katharinanilss/SO_26_EPS_PCB/so_26_eps_pcb/so_26_eps_pcb.kicad_pcb

## KiCad design so_26_eps_pcb/so_26_eps_pcb.kicad_pcb (2026-03-01)

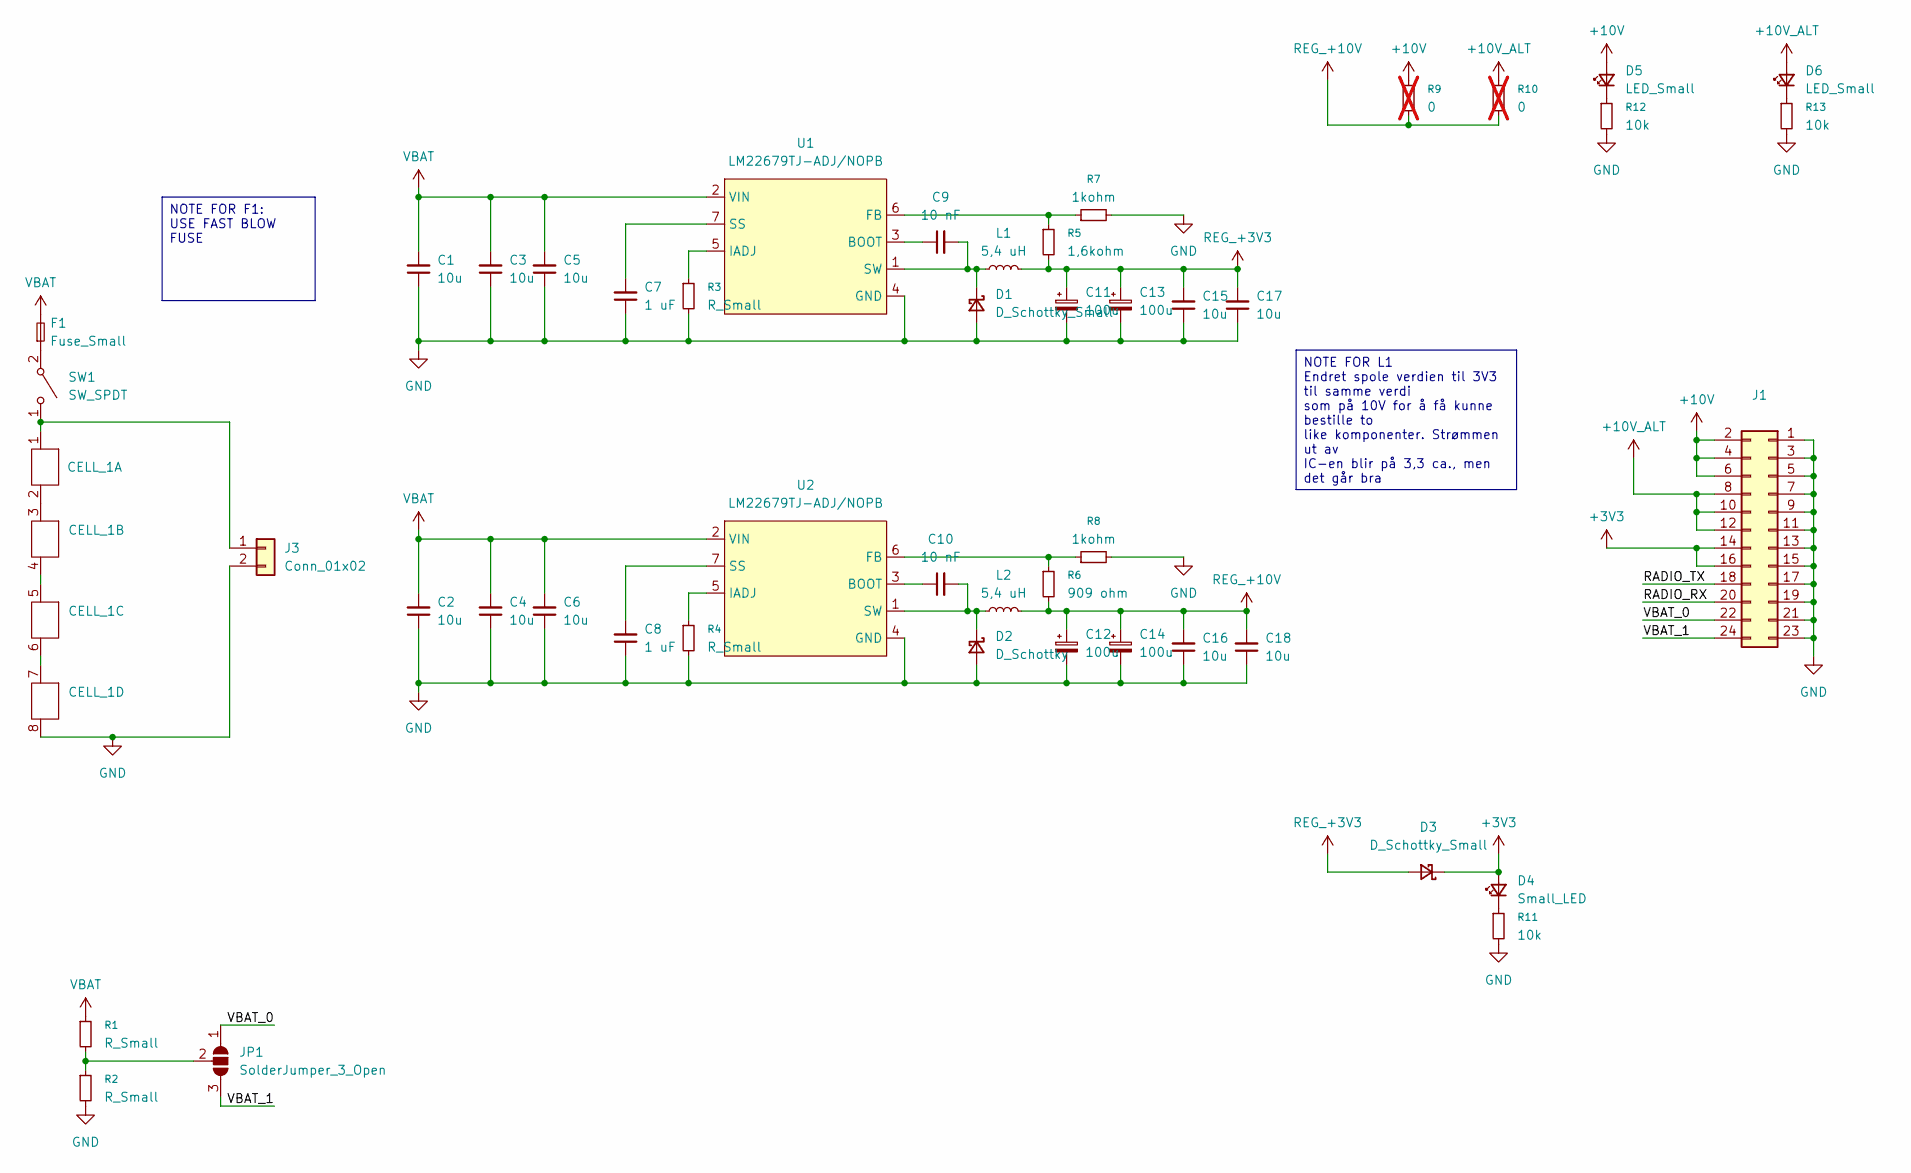
[picture p1: schematic so_26_eps_pcb.kicad_sch, SO26 - EPS]

Parts:
C1, C2, C3, C4, C5, C6, C15, C16, C17, C18: 10u; C_1206_3216Metric_Pad1.33x1.80mm_HandSolder
C7, C8: 1 uF; C_1206_3216Metric_Pad1.33x1.80mm_HandSolder
C9, C10: 10 nF; C_0805_2012Metric_Pad1.18x1.45mm_HandSolder
C11, C12, C13, C14: 100u; CP_Radial_D6.3mm_P2.50mm
CELL_1: Battery holder
D1, D3: D_Schottky_Small; D_SOD-128
D2: D_Schottky; D_SOD-128
D4: Small_LED; LED_0805_2012Metric_Pad1.15x1.40mm_HandSolder
D5, D6: LED_Small; LED_0805_2012Metric_Pad1.15x1.40mm_HandSolder
F1: Fuse_Small; Surface Mount Fuse Block
J1: Conn_02x12_Odd_Even; PinSocket_2x12_P2.54mm_Vertical
J3: Conn_01x02; 01x02_header
JP1: SolderJumper_3_Open; SolderJumper-3_P2.0mm_Open_TrianglePad1.0x1.5mm_NumberLabels
L1, L2: 5,4 uH; SRU1048 Inductor
R1, R2, R3, R4: R_Small; R_0805_2012Metric_Pad1.20x1.40mm_HandSolder
R5: 1,6kohm; R_0805_2012Metric_Pad1.20x1.40mm_HandSolder
R6: 909 ohm; R_0805_2012Metric_Pad1.20x1.40mm_HandSolder
R7, R8: 1kohm; R_0805_2012Metric_Pad1.20x1.40mm_HandSolder
R9, R10: 0; R_2512_6332Metric_Pad1.40x3.35mm_HandSolder; not fitted
R11, R12, R13: 10k; R_0805_2012Metric_Pad1.20x1.40mm_HandSolder
SW1: SW_SPDT; finalswitchfinal
U1, U2: LM22679TJ-ADJ/NOPB; TO-263-7_TabPin4

Connections:
+3V3: D3.1 (K), D4.2 (A), J1.14, J1.16
+10V: D5.2 (A), J1.2, J1.4, J1.6, R9.1
+10V_ALT: D6.2 (A), J1.8, J1.10, J1.12, R10.1
/RADIO_RX: J1.20
/RADIO_TX: J1.18
/VBAT_0: J1.22, JP1.1 (A)
/VBAT_1: J1.24, JP1.3 (B)
GND: C1.1, C2.1, C3.1, C4.1, C5.1, C6.1, C7.1, C8.1, C11.2, C12.2, C13.2, C14.2, C15.1, C16.1, C17.1, C18.1, CELL_1.8, D1.2 (A), D2.2 (A), J1.1, J1.3, J1.5, J1.7, J1.9, J1.11, J1.13, J1.15, J1.17, J1.19, J1.21, J1.23, J3.2, R2.2, R3.2, R4.2, R7.2, R8.2, R11.2, R12.2, R13.2, U1.4 (GND), U2.4 (GND)
unnamed: CELL_1.2, CELL_1.3
unnamed: CELL_1.4, CELL_1.5
unnamed: CELL_1.6, CELL_1.7
unnamed: C9.2, D1.1 (K), L1.1, U1.1 (SW)
unnamed: C10.2, D2.1 (K), L2.1, U2.1 (SW)
unnamed: D4.1 (K), R11.1
unnamed: D5.1 (K), R12.1
unnamed: D6.1 (K), R13.1
unnamed: CELL_1.1, J3.1, SW1.1 (A)
unnamed: JP1.2 (C), R1.2, R2.1
unnamed 18: F1.1, SW1.2 (B); also elsewhere on the board
unnamed: C9.1, U1.3 (BOOT)
unnamed: R5.1, R7.1, U1.6 (FB)
unnamed: R3.1, U1.5 (IADJ)
unnamed: C7.2, U1.7 (SS)
unnamed: C10.1, U2.3 (BOOT)
unnamed: R6.1, R8.1, U2.6 (FB)
unnamed: R4.1, U2.5 (IADJ)
unnamed: C8.2, U2.7 (SS)
REG_+3V3: C11.1, C13.1, C15.2, C17.2, D3.2 (A), L1.2, R5.2
REG_+10V: C12.1, C14.1, C16.2, C18.2, L2.2, R6.2, R9.2, R10.2
VBAT: C1.2, C2.2, C3.2, C4.2, C5.2, C6.2, F1.2, R1.1, U1.2 (VIN), U2.2 (VIN); also elsewhere on the board

Notes on the sheet:
NOTE FOR F1: USE FAST BLOW FUSE
NOTE FOR L1 Endret spole verdien til 3V3 til samme verdi som på 10V for å få kunne bestille to like komponenter. Strømmen ut av IC-en blir på 3,3 ca., men det går bra

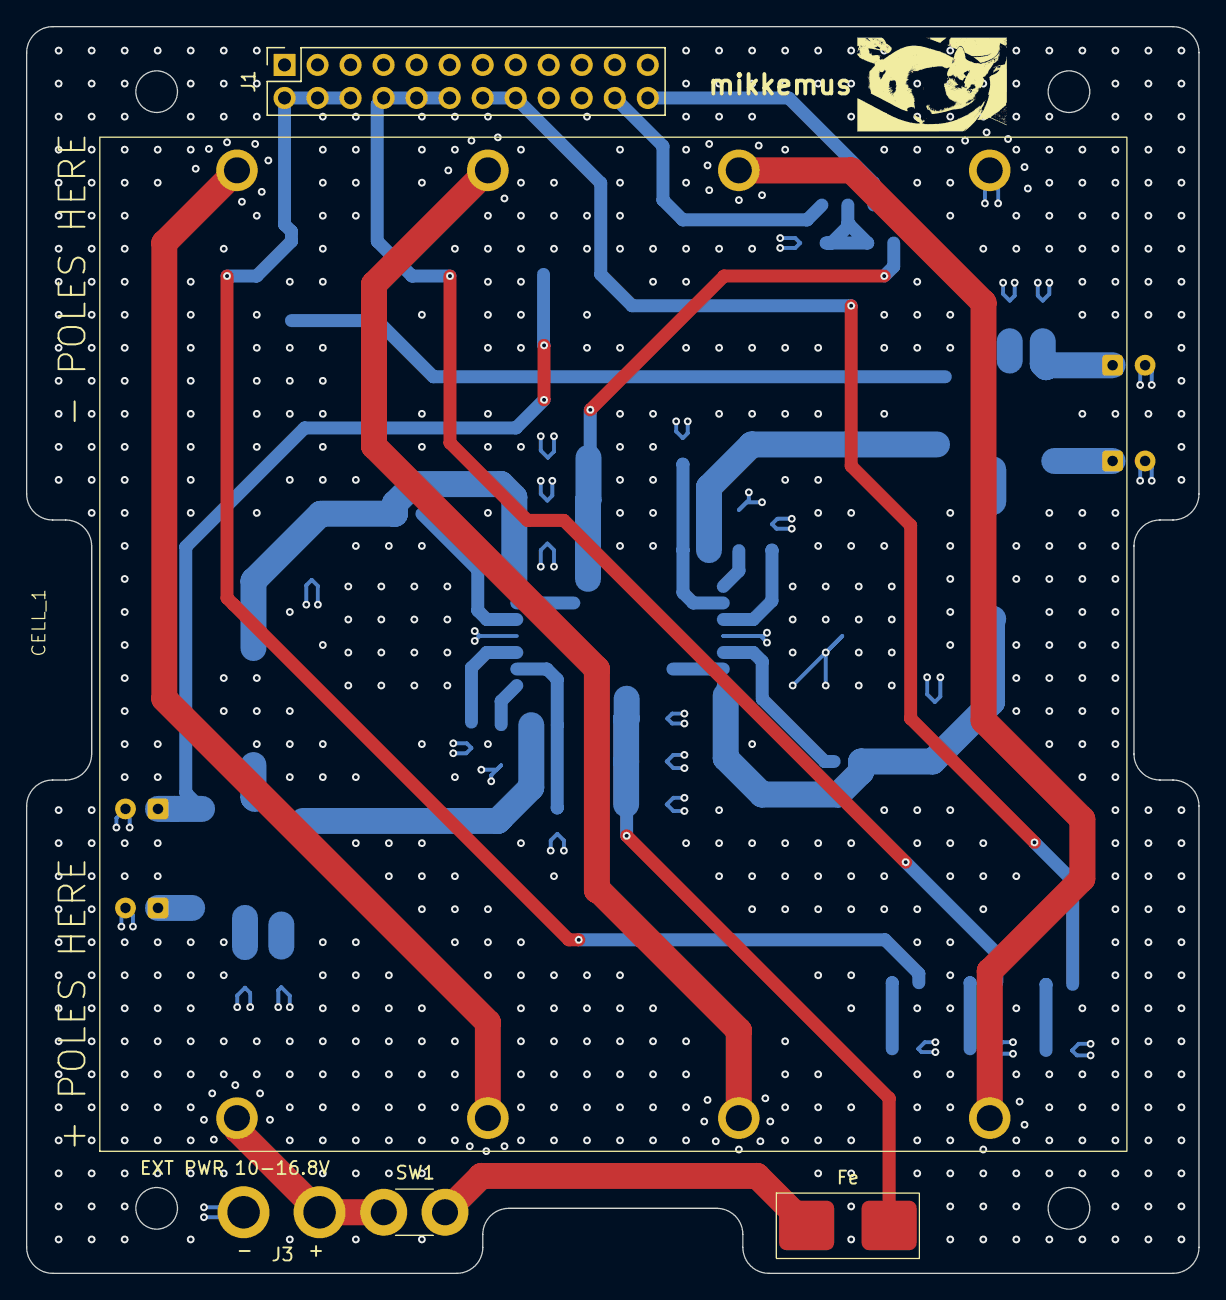
[picture p2: board so_26_eps_pcb.kicad_pcb from above]

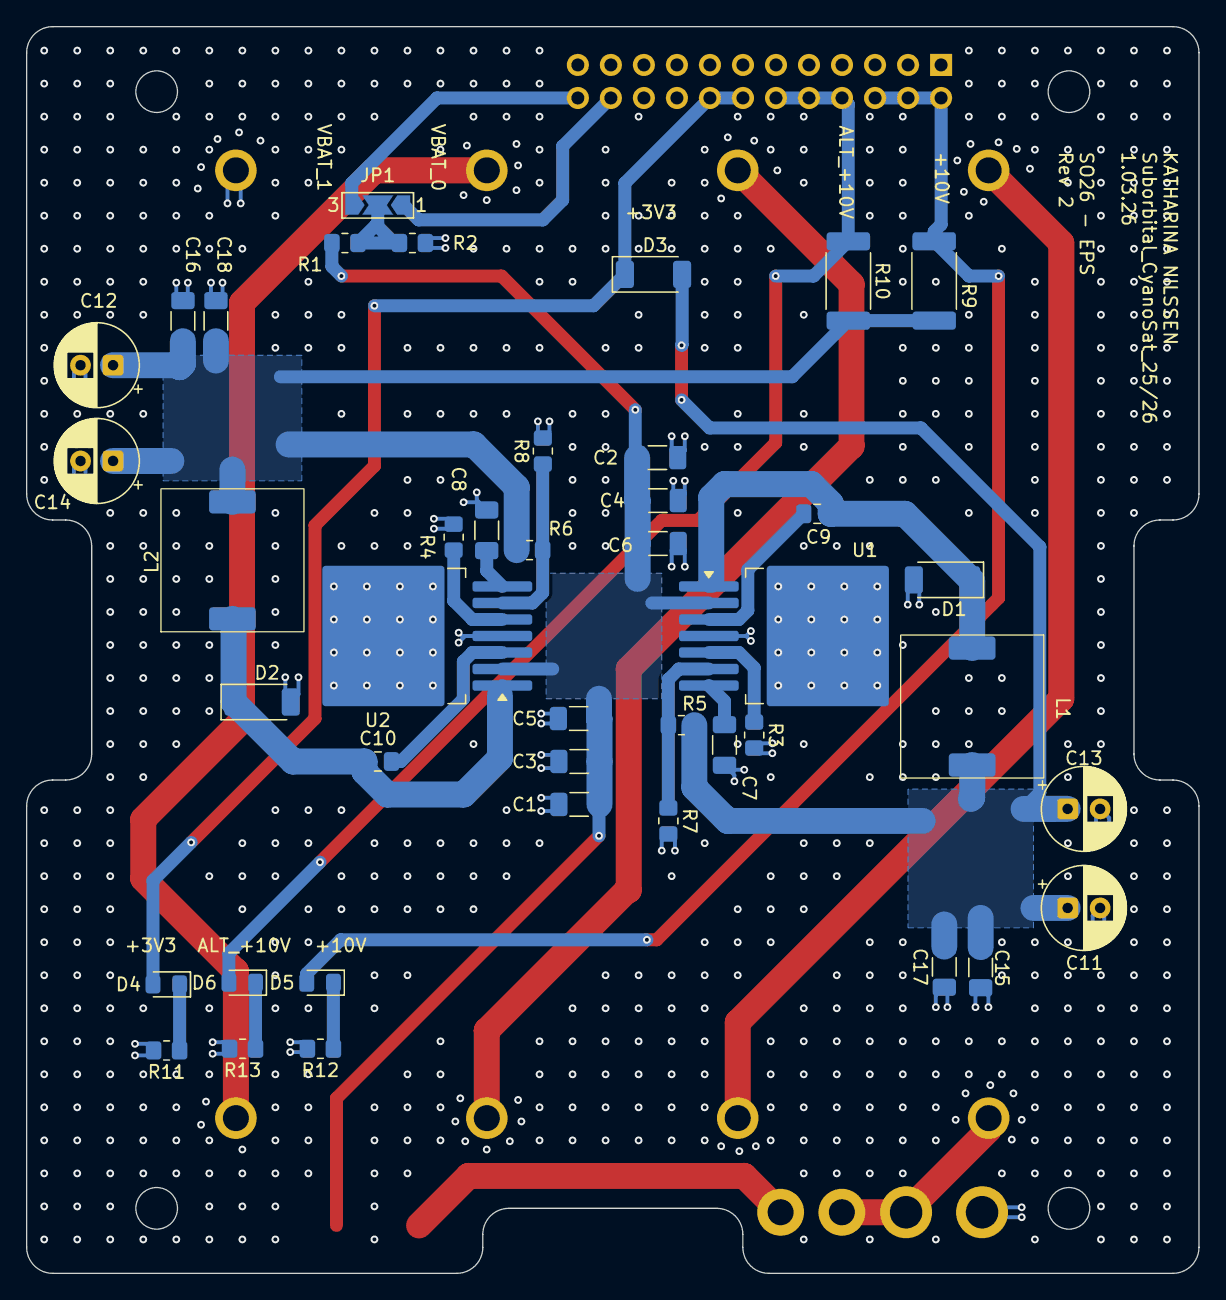
[picture p3: board so_26_eps_pcb.kicad_pcb from below]

Board: 4 copper layers, 90.2 x 95.9 mm, 48 parts (42 on the bottom side), 28 nets.

Other parts of the board:
Fe: Fuse_Small; Surface Mount Fuse Block
mikkemus: LOGO

Their connections:
unnamed 18: Fe.1; also elsewhere on the board
VBAT: Fe.2; also elsewhere on the board
