katharinanilss/SO_26_EPS_PCB/(commit log)

2026-01-28 init commit
    [so_26_eps_pcb.kicad_pcb, so_26_eps_pcb.kicad_sch]
2026-01-28 schematic: updated title block
    [so_26_eps_pcb.kicad_sch]
2026-02-06 Laget symbol for LM22679TJ-ADJ/NOPB
    Laget symbol for LM22679TJ-ADJ/NOPB
    [so_26_eps_pcb.kicad_sch]
2026-02-06 Laget ferdig regulatorer
    Mangler noen verdier
    [so_26_eps_pcb.kicad_sch]
2026-02-06 Battery
    Yuhhh
    [so_26_eps_pcb.kicad_sch]
2026-02-06 Battery symbol
    I have made one symbol, battery, that contains 4 different units which represent the 4 batteries in one battery holder
2026-02-06 Finished
    The circuit design are finished!!!
    [so_26_eps_pcb.kicad_sch]
2026-02-08 checked by aj
    schematic
    - fixed symbols and added capacitors
    pcb
    - added outline and stack + some footprints
    [so_26_eps_pcb.kicad_pcb, so_26_eps_pcb.kicad_sch]
2026-02-08 Made footprints
2026-02-08 Added test points
    [so_26_eps_pcb.kicad_sch]
2026-02-08 Changed properties for L
    [so_26_eps_pcb.kicad_pcb]
2026-02-08 Made a new battery holder
    Lets hope this one doesn’t get an error!
2026-02-08 Changed battery cells
    Gave input and outputs their own number
    [so_26_eps_pcb.kicad_sch]
2026-02-08 Made battery holder footprint
    [so_26_eps_pcb.kicad_sch]
2026-02-08 Added the last footprints
    [so_26_eps_pcb.kicad_pcb, so_26_eps_pcb.kicad_sch]
2026-02-08 Edits on PCB editor
2026-02-08 Last info about footprints
2026-02-09 Updated some footprints
    Deleted some old components and changed the size on the testpoints from 2mm in diameters to 1.5mm in diameters
    [so_26_eps_pcb.kicad_pcb]
2026-02-09 Made footprints for header by switch
2026-02-09 Added two headers to the system
    [so_26_eps_pcb.kicad_sch]
2026-02-09 pcb
    placed components close to each other to get an visual of the space
2026-02-09 Saved the pcb file
    [so_26_eps_pcb.kicad_pcb]
2026-02-10 Changed header footprint
    changed the header footprint, but it won’t update in the pcb editor
    [so_26_eps_pcb.kicad_pcb]
2026-02-10 Rev 1 of placing components on pcb
    [so_26_eps_pcb.kicad_pcb]
2026-02-10 Changed the place on some of the components on the PCB
    [so_26_eps_pcb.kicad_pcb]
2026-02-10 Saved the pcb
2026-02-10 Started some rooting
    [so_26_eps_pcb.kicad_pcb]
2026-02-10 Finished rooting the positive parts
    [so_26_eps_pcb.kicad_pcb]
2026-02-11 Saved
    some changes needs to be done on the wires
    [so_26_eps_pcb.kicad_pcb, so_26_eps_pcb.kicad_sch]
2026-02-11 Changed the thickness on some wires
    [so_26_eps_pcb.kicad_pcb]
2026-02-11 REV 1 FINAL
    SHEMATIC AND PCB CHECK
    DRC/ERC PASSED
    [so_26_eps_pcb.kicad_pcb, so_26_eps_pcb.kicad_sch]
2026-02-11 added via stiching
    [so_26_eps_pcb.kicad_pcb]
2026-02-11 added text "ext pwr 10-16.8v"
    [so_26_eps_pcb.kicad_pcb]
2026-02-11 added rev 1 text
    [bom.csv, designators.csv, positions.csv, so_26_eps_pcb.kicad_pcb]
2026-02-12 added text
    [so_26_eps_pcb.kicad_pcb, so_26_eps_pcb.kicad_sch]
2026-02-22 Placed components for 10V
    Also made a filled zone for VBAT
    [so_26_eps_pcb.kicad_pcb]
2026-02-22 Placed VBAT components and wiring
    [so_26_eps_pcb.kicad_pcb]
2026-02-24 Tried to make a design of the 10V reg and started on the 3V3 reg
2026-02-24 Started the 3V3 reg
    [so_26_eps_pcb.kicad_pcb]
2026-02-25 Finished the 3V3 reg
    [so_26_eps_pcb.kicad_pcb]
2026-02-25 Uptaded switch footprints
    [so_26_eps_pcb.kicad_pcb, so_26_eps_pcb.kicad_sch]
2026-03-01 Traced and placed the last components
    [so_26_eps_pcb.kicad_pcb]
2026-03-01 Feel like i finshed
    [so_26_eps_pcb.kicad_pcb]
2026-03-01 Added an image
    [so_26_eps_pcb.kicad_pcb]
2026-03-01 changed the image a bit
    [so_26_eps_pcb.kicad_pcb]
2026-03-01 last changes
    [so_26_eps_pcb.kicad_pcb]
